r-best/packmate/sprites/battery.jpg

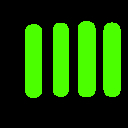
sprites/battery.jpg
