r-best/packmate/sprites/ui_base.jpg

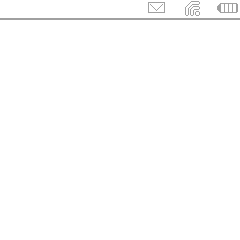
sprites/ui_base.jpg
