r-best/packmate/pcb/packmate.csv

Reference | Qty | Value | DNP | Exclude from BOM | Exclude from Board | Footprint | Datasheet
A1 | 1 | RaspberryPi_Pico_W |  |  |  | Module:RaspberryPi_Pico_Common_THT | https://datasheets.raspberrypi.com/picow/pico-w-datasheet.pdf
BT1 | 1 | Battery |  |  | Excluded from board
BZ1 | 1 | Buzzer |  |  |  | Buzzer_Beeper:Buzzer_12x9.5RM7.6
C1,C2,C4,C5,C6,C7,C8 | 7 | 0.1uf |  |  |  | Capacitor_SMD:C_01005_0402Metric
C3 | 1 | 400uf |  |  |  | Capacitor_SMD:CP_Elec_3x5.3
D1 | 1 | BLU |  |  |  | LED_SMD:LED_0201_0603Metric
D2 | 1 | RED |  |  |  | LED_SMD:LED_0201_0603Metric
D3 | 1 | GRN |  |  |  | LED_SMD:LED_0201_0603Metric
D4 | 1 | WHT |  |  |  | LED_SMD:LED_0201_0603Metric
D5 | 1 | Wireless In Use LED |  |  |  | LED_SMD:LED_0201_0603Metric
D6,D7,D8,D9,D10,D11,D12,D13,D14,D15 | 10 | WS2812B |  |  |  | LED_SMD:LED_WS2812B_PLCC4_5.0x5.0mm_P3.2mm | https://cdn-shop.adafruit.com/datasheets/WS2812B.pdf
J2 | 1 | DISPLAY |  |  |  | Connector_FFC-FPC:Hirose_FH12-12S-0.5SH_1x12-1MP_P0.50mm_Horizontal
J5 | 1 | Conn_01x04 |  |  | Excluded from board | Connector_PinHeader_2.54mm:PinHeader_1x04_P2.54mm_Vertical
J6 | 1 | Conn_01x02 |  |  | Excluded from board | Connector_JST:JST_PH_S2B-PH-K_1x02_P2.00mm_Horizontal
J7 | 1 | MICROSD |  |  |  | MSD-4-A.pretty:CONN9_MSD-4-A_SSD | MSD-4-A
Q1 | 1 | 2N7002E |  |  |  | Package_TO_SOT_SMD:SOT-23 | http://www.diodes.com/assets/Datasheets/ds30376.pdf
R1,R2,R3,R4 | 4 | 180 |  |  |  | Resistor_SMD:R_0201_0603Metric
R5,R6,R7,R8 | 4 | 10k |  |  |  | Resistor_SMD:R_0201_0603Metric
R9 | 1 | 10 |  |  |  | Resistor_SMD:R_0201_0603Metric
R10 | 1 | 20 |  |  |  | Resistor_SMD:R_0201_0603Metric
R11,R12 | 2 | 30k |  |  |  | Resistor_SMD:R_0201_0603Metric
SW1 | 1 | BTN |  |  |  | TL3315NF100Q:TL3315NF100Q_EWI
SW2 | 1 | Reset Button |  |  |  | Button_Switch_THT:SW_PUSH_6mm
SW3 | 1 | Left Button |  |  |  | Button_Switch_THT:SW_PUSH_6mm
SW4 | 1 | Right Button |  |  |  | Button_Switch_THT:SW_PUSH_6mm
SW6 | 1 | Wireless On/Off Switch |  |  |  | Button_Switch_THT:SW_E-Switch_EG1224_SPDT_Angled
U1 | 1 | UP |  |  |  | TMAG5231C1GQDBZR.pretty:SOT-23-3_DBZ_TEX | https://www.ti.com/lit/gpn/tmag5231
U2 | 1 | DWN |  |  |  | TMAG5231C1GQDBZR.pretty:SOT-23-3_DBZ_TEX | https://www.ti.com/lit/gpn/tmag5231
U3 | 1 | LFT |  |  |  | TMAG5231C1GQDBZR.pretty:SOT-23-3_DBZ_TEX | https://www.ti.com/lit/gpn/tmag5231
U4 | 1 | RHT |  |  |  | TMAG5231C1GQDBZR.pretty:SOT-23-3_DBZ_TEX | https://www.ti.com/lit/gpn/tmag5231
