r-best/packmate/(list of files, cad)

Other CAD files:
pcb/Untitled.blend
