r-best/packmate/pcb/packmate.kicad_pcb

## KiCad design pcb/packmate.kicad_pcb (2026-10-18)

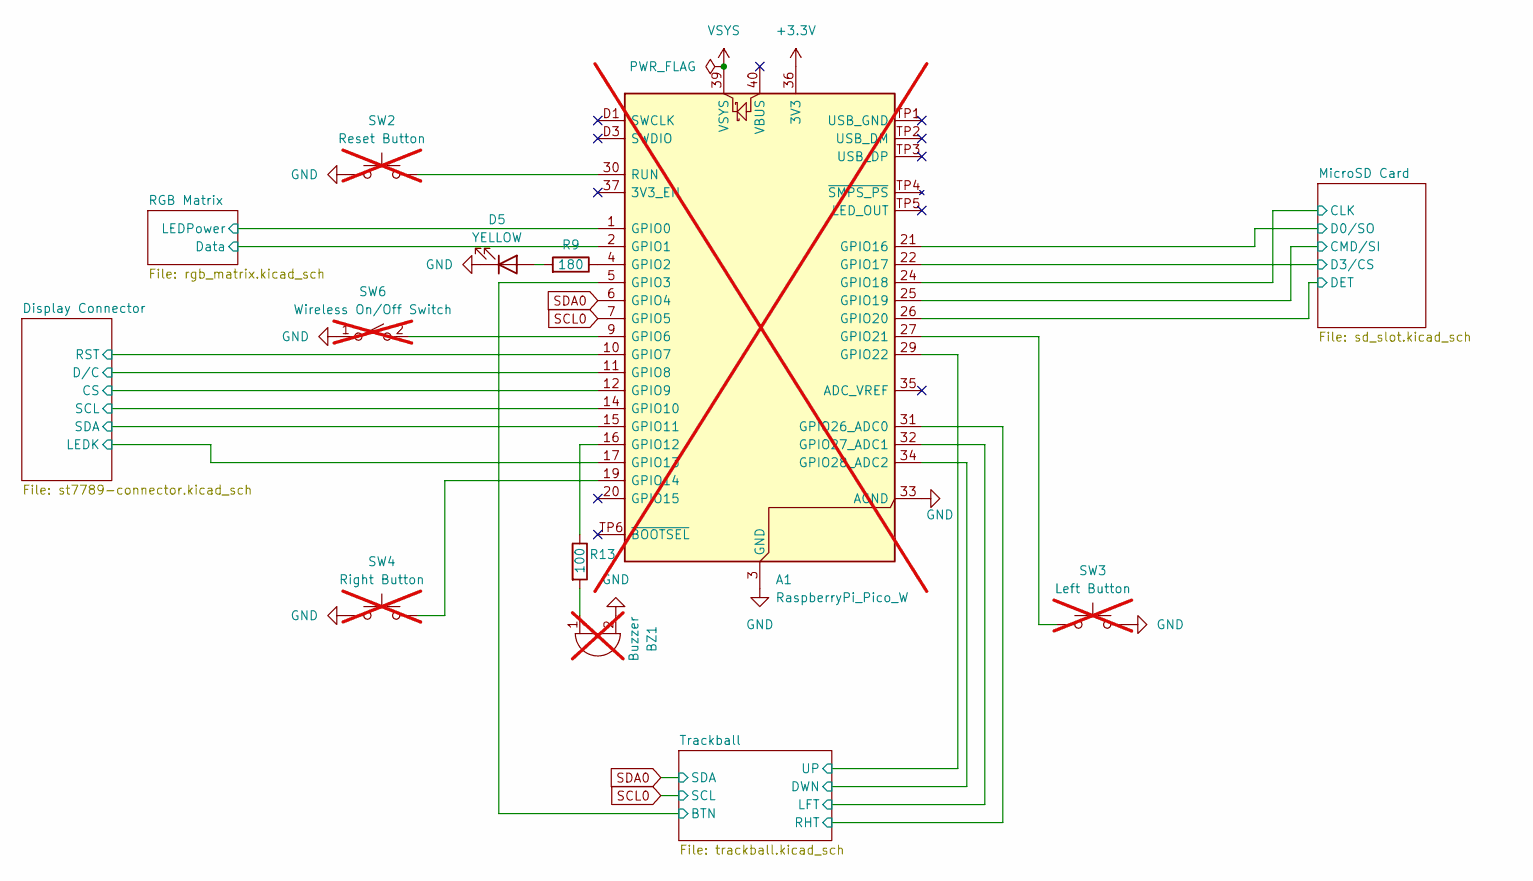
[picture p3: schematic packmate.kicad_sch]

Parts:
A1: RaspberryPi_Pico_W; RaspberryPi_Pico_Common_THT; not fitted
BZ1: Buzzer; Buzzer_TDK_PS1240P02BT_D12.2mm_H6.5mm; MPN PS1240P02BT; not fitted
D5: YELLOW; LED_0402_1005Metric; MPN APHHS1005SYCK
R9: 180; R_0603_1608Metric; MPN CRGCQ0603F180R
R13: 100; R_0603_1608Metric; MPN ERJ-3EKF1000V
SW2: Reset Button; SW_PUSH_6mm; MPN B3F-1000; not fitted
SW3: Left Button; SW_PUSH_6mm; MPN B3F-1000; not fitted
SW4: Right Button; SW_PUSH_6mm; MPN B3F-1000; not fitted
SW6: Wireless On/Off Switch; SW_E-Switch_EG1224_SPDT_Angled; MPN EG1224; not fitted

Connections:
+3.3V: A1.36 (3V3); also elsewhere on the board
/Display Connector/CS: A1.12 (GPIO9); also elsewhere on the board
/Display Connector/D/C: A1.11 (GPIO8); also elsewhere on the board
/Display Connector/LEDK: A1.17 (GPIO13); also elsewhere on the board
/Display Connector/RST: A1.10 (GPIO7); also elsewhere on the board
/Display Connector/SCL: A1.14 (GPIO10); also elsewhere on the board
/Display Connector/SDA: A1.15 (GPIO11); also elsewhere on the board
/MicroSD Card/CLK: A1.24 (GPIO18); also elsewhere on the board
/MicroSD Card/CMD/SI: A1.25 (GPIO19); also elsewhere on the board
/MicroSD Card/D0/SO: A1.21 (GPIO16); also elsewhere on the board
/MicroSD Card/D3/CS: A1.22 (GPIO17); also elsewhere on the board
/MicroSD Card/DET: A1.26 (GPIO20); also elsewhere on the board
/RGB Matrix/Data: A1.2 (GPIO1); also elsewhere on the board
/RGB Matrix/LEDPower: A1.1 (GPIO0); also elsewhere on the board
/Trackball/BTN: A1.5 (GPIO3); also elsewhere on the board
/Trackball/DWN: A1.34 (GPIO28_ADC2); also elsewhere on the board
/Trackball/LFT: A1.32 (GPIO27_ADC1); also elsewhere on the board
/Trackball/RHT: A1.31 (GPIO26_ADC0); also elsewhere on the board
/Trackball/UP: A1.29 (GPIO22); also elsewhere on the board
GND: A1.3 (GND), A1.8 (GND), A1.13 (GND), A1.18 (GND), A1.23 (GND), A1.28 (GND), A1.33 (AGND), A1.38 (GND), A1.D2 (GND), BZ1.2 (-), D5.1 (K), SW2.1, SW3.1, SW4.1, SW6.1 (A); also elsewhere on the board
unnamed: A1.4 (GPIO2), R9.1
unnamed: A1.9 (GPIO6), SW6.2 (B)
unnamed: A1.16 (GPIO12), R13.1
unnamed: A1.19 (GPIO14), SW4.2
unnamed: A1.27 (GPIO21), SW3.2
unnamed: A1.30 (RUN), SW2.2
unnamed: BZ1.1 (+), R13.2
unnamed: D5.2 (A), R9.2
SCL0: A1.7 (GPIO5); also elsewhere on the board
SDA0: A1.6 (GPIO4); also elsewhere on the board
VSYS: A1.39 (VSYS); also elsewhere on the board

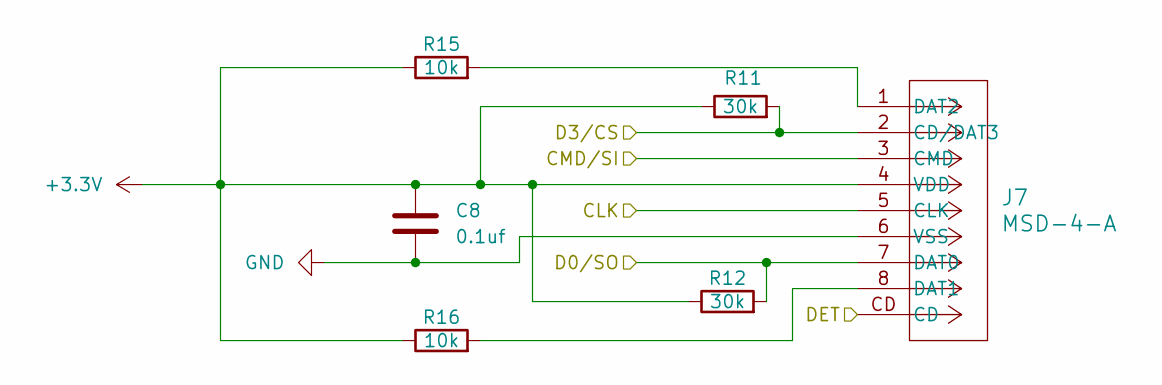
[picture p4: schematic sd_slot.kicad_sch]

Parts:
C8: 0.1uf; C_0402_1005Metric; MPN GRM155R71H104KE14D
J7: MSD-4-A; CONN9_MSD-4-A_SSD; MPN MSD-4-A
R11, R12: 30k; R_0603_1608Metric; MPN RC0603FR-0730KL
R15, R16: 10k; R_0603_1608Metric; MPN CRCW060310K0FKEA

Connections:
+3.3V: C8.2, J7.4 (VDD), R11.1, R12.1, R15.1, R16.1; also elsewhere on the board
/MicroSD Card/CLK: J7.5 (CLK); also elsewhere on the board
/MicroSD Card/CMD/SI: J7.3 (CMD); also elsewhere on the board
/MicroSD Card/D0/SO: J7.7 (DAT0), R12.2; also elsewhere on the board
/MicroSD Card/D3/CS: J7.2 (CD/DAT3), R11.2; also elsewhere on the board
/MicroSD Card/DET: J7.CD; also elsewhere on the board
GND: C8.1, J7.6 (VSS); also elsewhere on the board
unnamed: J7.8 (DAT1), R16.2
unnamed: J7.1 (DAT2), R15.2

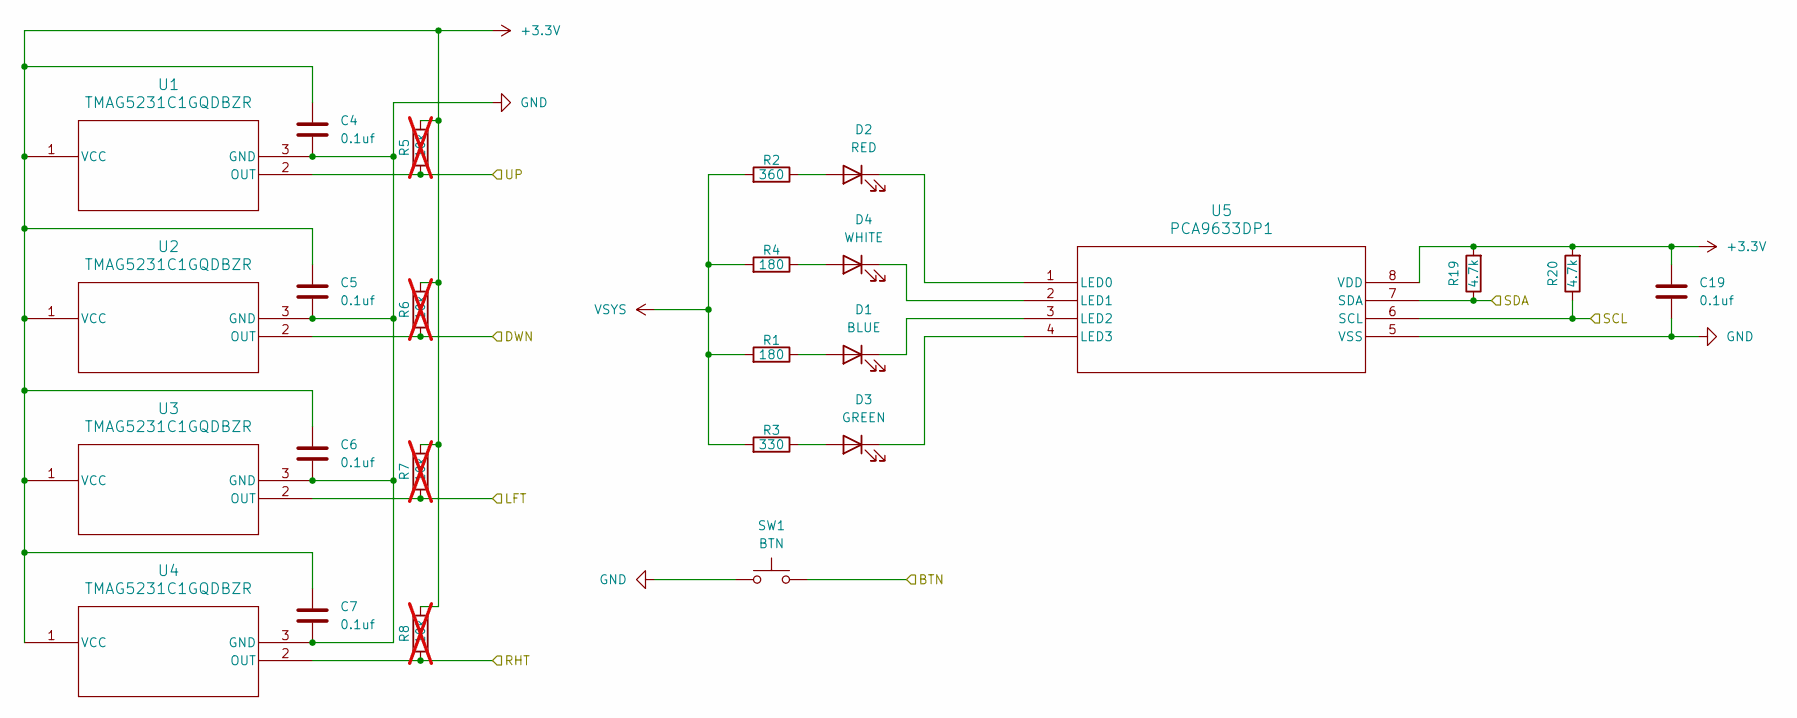
[picture p5: schematic trackball.kicad_sch]

Parts:
C4, C5, C6, C7, C19: 0.1uf; C_0402_1005Metric; MPN GRM155R71H104KE14D
D1: BLUE; LED_0402_1005Metric; MPN APHHS1005QBC/D
D2: RED; LED_0402_1005Metric; MPN APHHS1005SURCK
D3: GREEN; LED_0402_1005Metric; MPN APHHS1005ZGC
D4: WHITE; LED_0402_1005Metric; MPN IN-S42BT5UW
R1, R4: 180; R_0201_0603Metric; MPN RC0201FR-07180RL
R2: 360; R_0201_0603Metric; MPN RC0201FR-07360RL
R3: 330; R_0201_0603Metric; MPN RC0201FR-07330RL
R5, R6, R7, R8: 10k; R_0201_0603Metric; MPN RC0201FR-0710KL; not fitted
R19, R20: 4.7k; R_0603_1608Metric; MPN RC0603FR-074K7L
SW1: BTN; TL3315NF100Q_EWI; MPN TL3315NF100Q
U1, U2, U3, U4: TMAG5231C1GQDBZR; SOT-23-3_DBZ_TEX; MPN TMAG5231C1GQDBZR
U5: PCA9633DP1; TSSOP-8_3x3mm_P0.65mm; MPN PCA9633DP1,118

Connections:
+3.3V: C4.1, C5.1, C6.1, C7.1, C19.2, R5.2, R6.2, R7.2, R8.2, R19.2, R20.2, U1.1 (VCC), U2.1 (VCC), U3.1 (VCC), U4.1 (VCC), U5.8 (VDD); also elsewhere on the board
/Trackball/BTN: SW1.2; also elsewhere on the board
/Trackball/DWN: R6.1, U2.2 (OUT); also elsewhere on the board
/Trackball/LFT: R7.1, U3.2 (OUT); also elsewhere on the board
/Trackball/RHT: R8.1, U4.2 (OUT); also elsewhere on the board
/Trackball/UP: R5.1, U1.2 (OUT); also elsewhere on the board
GND: C4.2, C5.2, C6.2, C7.2, C19.1, SW1.1, U1.3 (GND), U2.3 (GND), U3.3 (GND), U4.3 (GND), U5.5 (VSS); also elsewhere on the board
unnamed: D1.2 (A), R1.1
unnamed: D1.1 (K), U5.3 (LED2)
unnamed: D2.2 (A), R2.1
unnamed: D2.1 (K), U5.1 (LED0)
unnamed: D3.2 (A), R3.1
unnamed: D3.1 (K), U5.4 (LED3)
unnamed: D4.2 (A), R4.1
unnamed: D4.1 (K), U5.2 (LED1)
SCL0: R20.1, U5.6 (SCL); also elsewhere on the board
SDA0: R19.1, U5.7 (SDA); also elsewhere on the board
VSYS: R1.2, R2.2, R3.2, R4.2; also elsewhere on the board

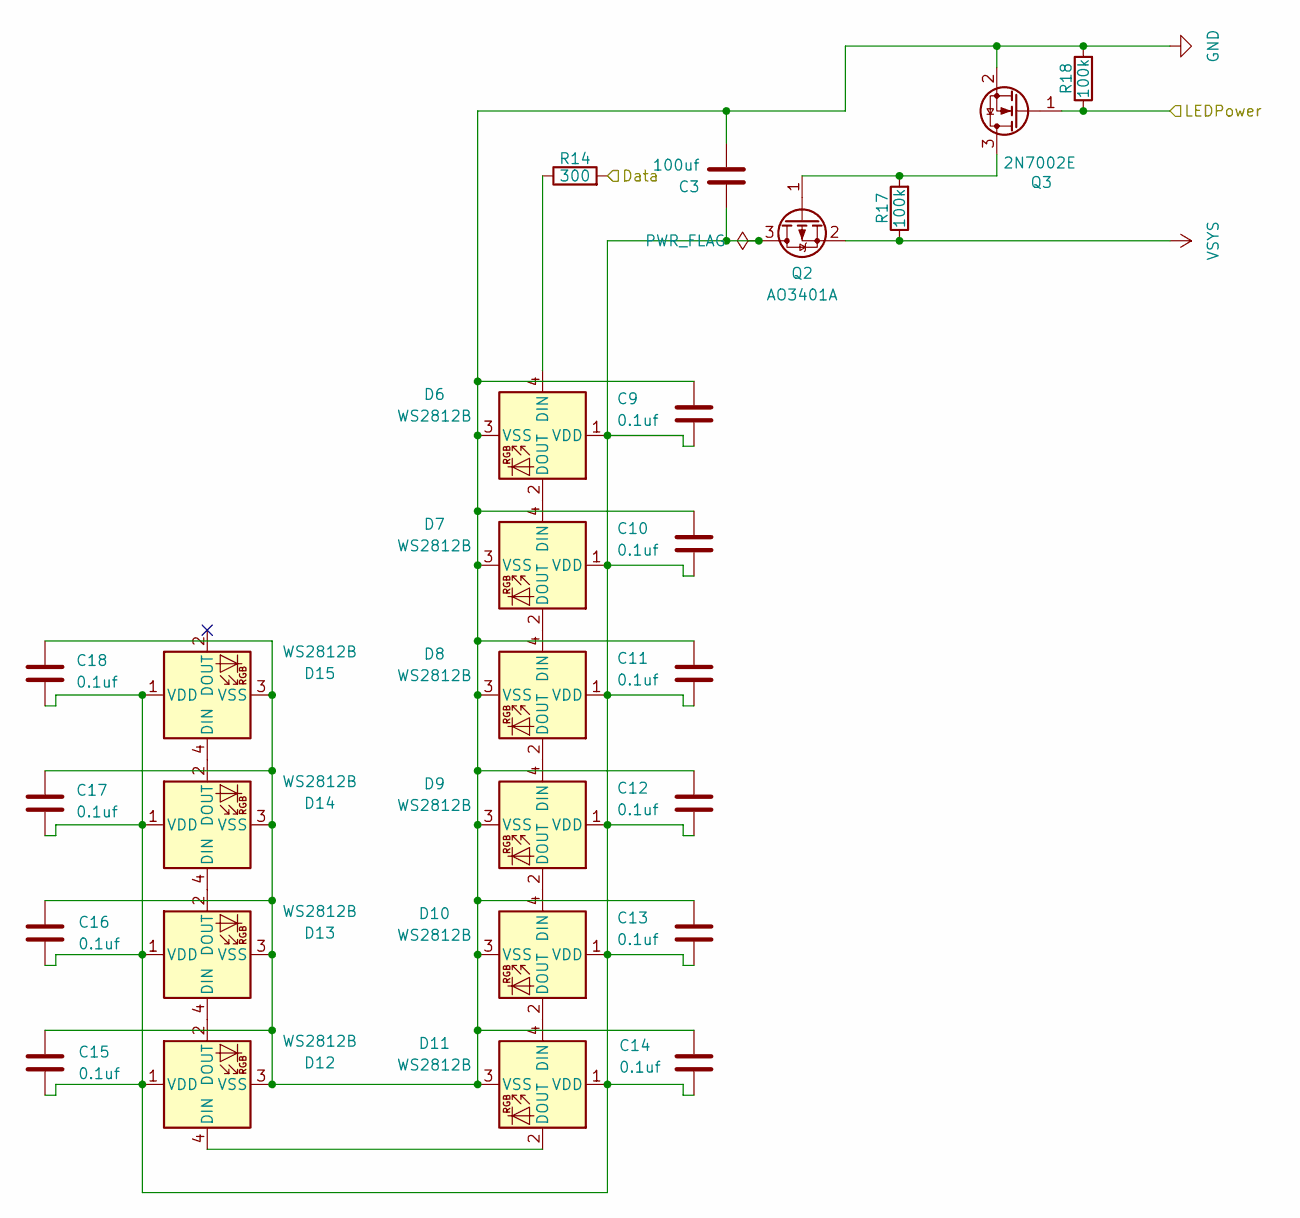
[picture p6: schematic rgb_matrix.kicad_sch]

Parts:
C3: 100uf; C_1206_3216Metric; MPN GRM31CR61A107MEA8L
C9, C10, C11, C12, C13, C14, C15, C16, C17, C18: 0.1uf; C_0402_1005Metric; MPN GRM155R71H104KE14D
D6, D7, D8, D9, D10, D11, D12, D13, D14, D15: WS2812B; LED_WS2812B_PLCC4_5.0x5.0mm_P3.2mm; MPN WS2812B
Q2: AO3401A; SOT-23; MPN AO3401A
Q3: 2N7002E; SOT-23; MPN 2N7002E-7-F
R14: 300; R_0603_1608Metric; MPN ERJ-3GEYJ301V
R17, R18: 100k; R_0603_1608Metric; MPN CRCW0603100KFKEA

Connections:
/RGB Matrix/Data: R14.2; also elsewhere on the board
/RGB Matrix/LEDPower: Q3.1 (G), R18.1; also elsewhere on the board
GND: C3.2, C9.1, C10.1, C11.1, C12.1, C13.1, C14.1, C15.1, C16.1, C17.1, C18.1, D6.3 (VSS), D7.3 (VSS), D8.3 (VSS), D9.3 (VSS), D10.3 (VSS), D11.3 (VSS), D12.3 (VSS), D13.3 (VSS), D14.3 (VSS), D15.3 (VSS), Q3.2 (S), R18.2; also elsewhere on the board
unnamed: D6.4 (DIN), R14.1
unnamed: D6.2 (DOUT), D7.4 (DIN)
unnamed: D7.2 (DOUT), D8.4 (DIN)
unnamed: D8.2 (DOUT), D9.4 (DIN)
unnamed: D9.2 (DOUT), D10.4 (DIN)
unnamed: D10.2 (DOUT), D11.4 (DIN)
unnamed: C3.1, C9.2, C10.2, C11.2, C12.2, C13.2, C14.2, C15.2, C16.2, C17.2, C18.2, D6.1 (VDD), D7.1 (VDD), D8.1 (VDD), D9.1 (VDD), D10.1 (VDD), D11.1 (VDD), D12.1 (VDD), D13.1 (VDD), D14.1 (VDD), D15.1 (VDD), Q2.3 (D)
unnamed: D11.2 (DOUT), D12.4 (DIN)
unnamed: D12.2 (DOUT), D13.4 (DIN)
unnamed: D13.2 (DOUT), D14.4 (DIN)
unnamed: D14.2 (DOUT), D15.4 (DIN)
unnamed: Q2.1 (G), Q3.3 (D), R17.2
VSYS: Q2.2 (S), R17.1; also elsewhere on the board

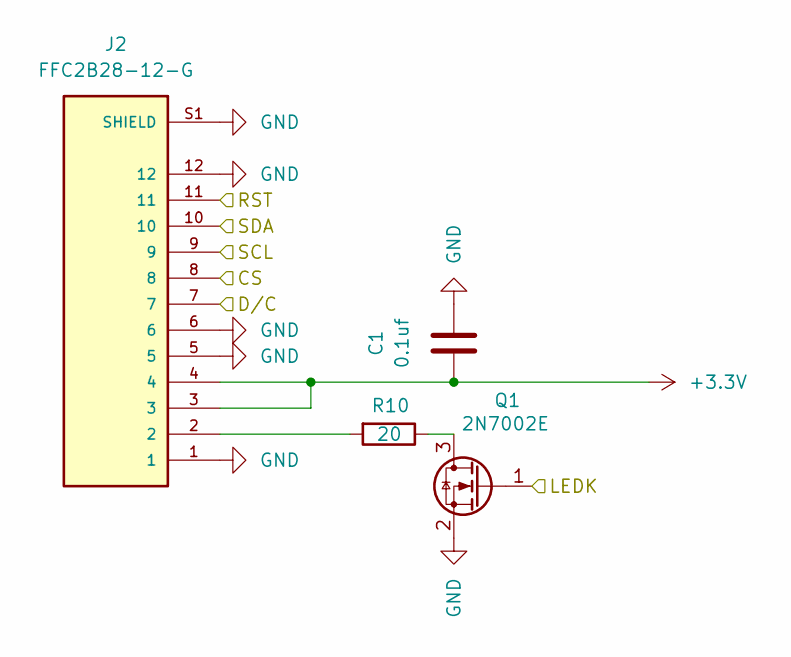
[picture p7: schematic st7789-connector.kicad_sch]

Parts:
C1: 0.1uf; C_0402_1005Metric; MPN GRM155R71H104KE14D
J2: FFC2B28-12-G; GCT_FFC2B28-12-G; MPN FFC2B28-12-G; DigiKey_Part_Number 2073-FFC2B28-12-GCT-ND
Q1: 2N7002E; SOT-23; MPN 2N7002E-7-F
R10: 20; R_0603_1608Metric; MPN RMCF0603JT20R0

Connections:
+3.3V: C1.2, J2.3, J2.4; also elsewhere on the board
/Display Connector/CS: J2.8; also elsewhere on the board
/Display Connector/D/C: J2.7; also elsewhere on the board
/Display Connector/LEDK: Q1.1 (G); also elsewhere on the board
/Display Connector/RST: J2.11; also elsewhere on the board
/Display Connector/SCL: J2.9; also elsewhere on the board
/Display Connector/SDA: J2.10; also elsewhere on the board
GND: C1.1, J2.1, J2.5, J2.6, J2.12, J2.S1 (SHIELD), J2.S2 (SHIELD), Q1.2 (S); also elsewhere on the board
unnamed: J2.2, R10.2
unnamed: Q1.3 (D), R10.1

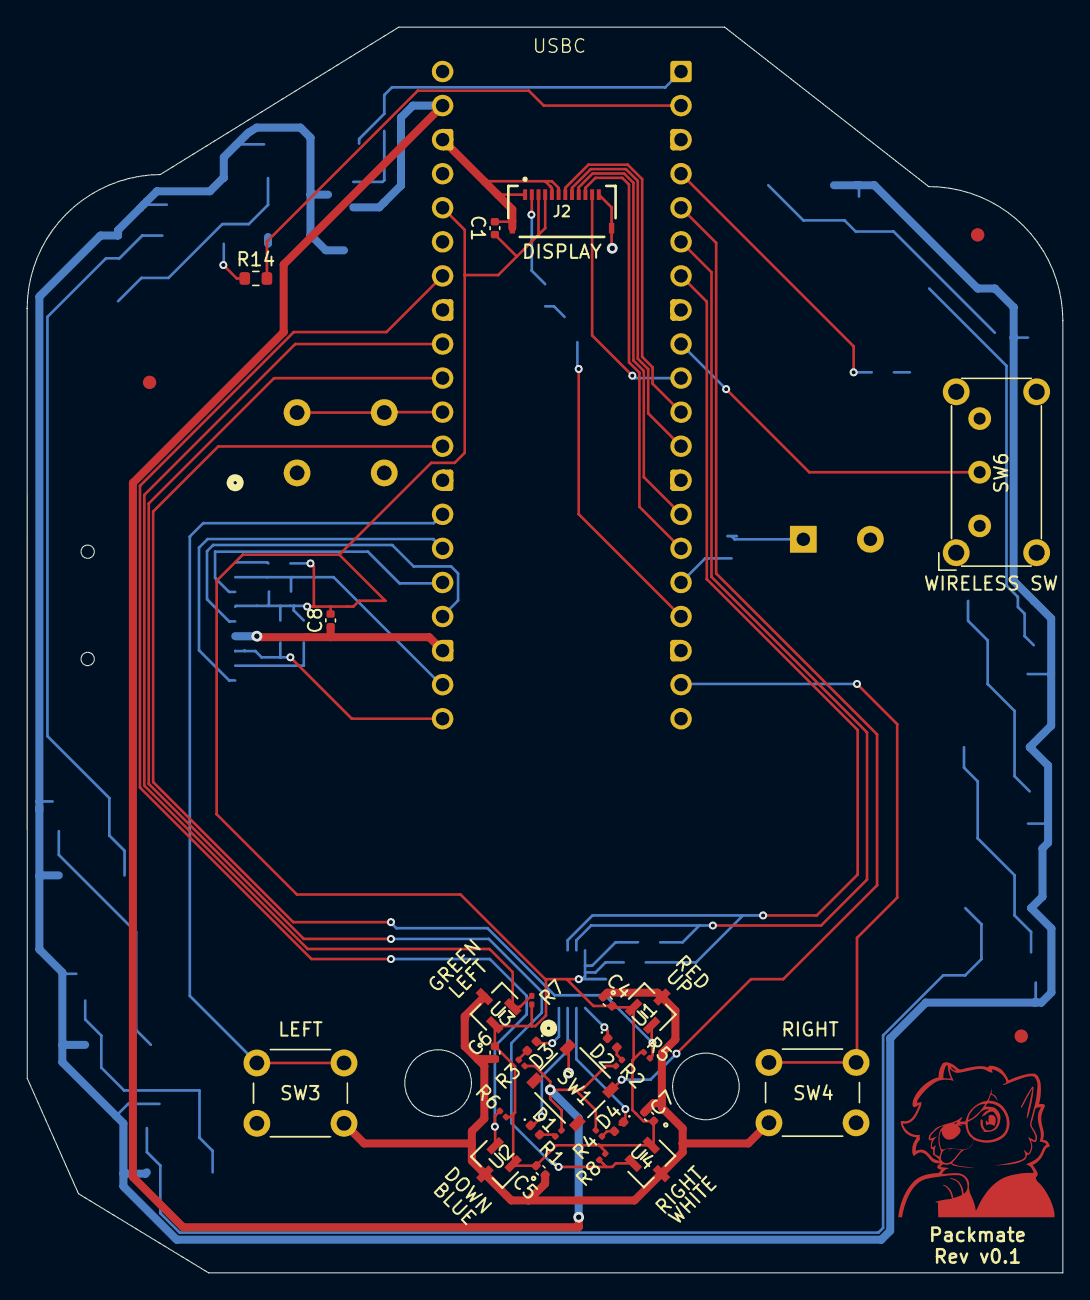
[picture p8: board packmate.kicad_pcb from above]

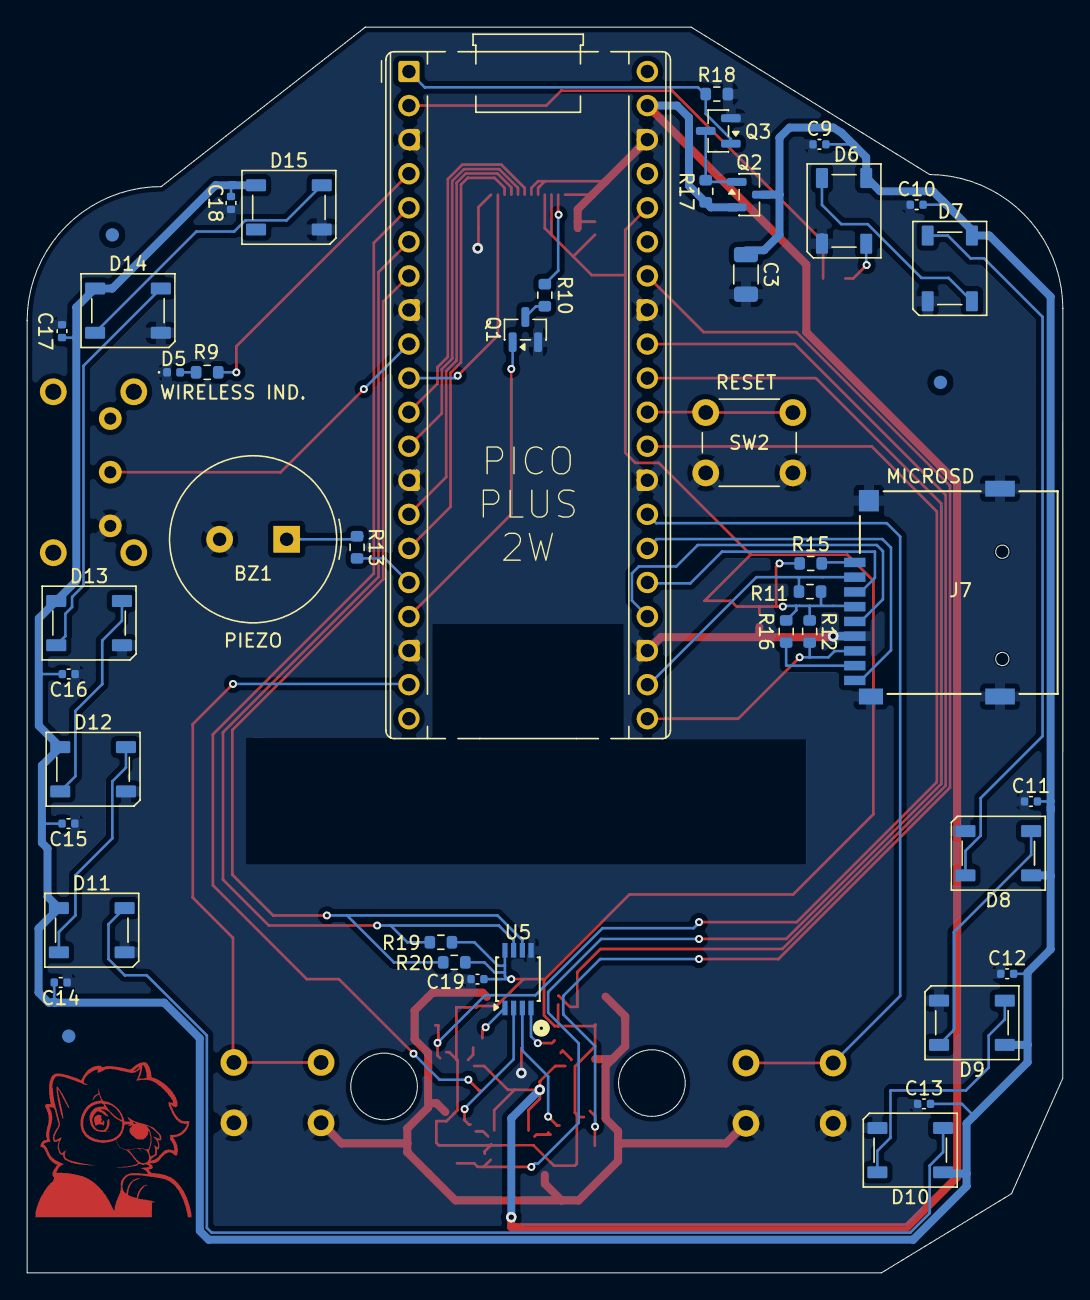
[picture p9: board packmate.kicad_pcb from below]

Board: 2 copper layers, 77.2 x 92.9 mm, 76 parts (45 on the bottom side), 55 nets.

Other parts of the board:
FID1, FID2, FID3, FID4, FID5, FID6: Fiducial_1mm_Mask2mm
