r-best/packmate/main.cpp

#include <stdio.h>
#include "pico/stdlib.h"
#include "pico/multicore.h"
#include "hardware/spi.h"
#include "pico/cyw43_arch.h"
#include "hardware/gpio.h"
#include "hardware/structs/xip.h"

#include "src/hardware/watchdog.h"
#include "src/screens/screen_manager.h"
#include "src/screens/home/home.h"
#include "src/screens/error/error.h"
#include "src/screens/boot/boot.h"
#include "src/screens/debug/debug.h"
#include "src/hardware/trackball.h"
#include "src/hardware/rgb_matrix.h"
#include "src/hardware/lcd.h"
#include "src/hardware/sd.h"
#include "src/hardware/buzzer.h"

#define DEBUG

#ifdef DEBUG
#include "tusb.h"
#endif

uint8_t MAIN_FPS = 60;
uint32_t FRAME_INTERVAL_US = 1000000 / MAIN_FPS; // Storing this as microseconds because the timer function returns microseconds
uint32_t WAIT_INTERVAL_MS = FRAME_INTERVAL_US / 4 / 1000; // Wait 1/4 of frame interval between loops to save CPU, no need to check constantly. Could probably even drop to 1/2

void set_fps(uint8_t fps) {
    MAIN_FPS = fps;
    FRAME_INTERVAL_US = 1000000 / MAIN_FPS;
}

BootScreen *bootScreen;

int init_debug_connections() {
    stdio_init_all();

    // Wait for terminal connection (with 5s timeout)
    for (int i = 0; i < 500; i++) {
        if (tud_cdc_connected()) break;
        sleep_ms(10);
    }
    sleep_ms(200);
    return 0;
}

int init_psram() {
    // Configure GPIO 47 as QSPI CS1 for the PSRAM chip
    gpio_set_function(PIMORONI_PICO_PLUS2_W_PSRAM_CS_PIN, GPIO_FUNC_XIP_CS1);

    // XIP window 1 is read-only by default; must opt in to writes for PSRAM.
    // Covers both cached (0x11000000) and uncached (0x15000000)
    // https://forums.raspberrypi.com/viewtopic.php?t=390346
    hw_set_bits(&xip_ctrl_hw->ctrl, XIP_CTRL_WRITABLE_M1_BITS);

    return 0;
}

int init_secondary_hardware() {
    int status;

    sleep_ms(500);

    printf("Initializing PSRAM\n");
    status = init_psram();
    bootScreen->update_status(3, status==0);

    printf("Mounting SD card\n");
    status = SD::init();
    bootScreen->update_status(4, status==0);

    sleep_ms(500);

    printf("Initializing buzzer\n");
    status = Buzzer::init();
    bootScreen->update_status(5, status==0);

    sleep_ms(500);

    // Initialise the Wi-Fi chip
    printf("Initializing wifi chip\n");
    if (cyw43_arch_init()) {
        printf("Wi-Fi init failed\n");
        bootScreen->update_status(6, false);
        return -1;
    }
    bootScreen->update_status(6, true);

    sleep_ms(500);

    Buzzer::play_melody("boot");
    return 0;
}

void core1_main() {
    printf("Second core initialized\n");

    init_secondary_hardware();
}

int main() {
    #ifdef DEBUG
    init_debug_connections();
    #endif

    printf("------------------------------------\n");
    printf("Starting Packmate!\n");

    bootScreen = new BootScreen();

    printf("Initializing screen\n");
    int status = LCD::init();
    bootScreen->update_status(0, status==0);
    
    // Try to initialize trackball first so we have the LED to light red on error
    printf("Initializing trackball\n");
    status = Trackball::init();
    bootScreen->update_status(1, status==0);

    multicore_launch_core1(core1_main);

    // Initialize RGB matrix
    printf("Initializing RGB matrix\n");
    status = RGBMatrix::init();
    bootScreen->update_status(2, status==0);

    InputState input;

    screenManager.push(new HomeScreen());

    // if (true) {
    if (watchdog::is_watchdog_reboot()) {
        printf("Rebooted by watchdog - there was some kind of error\n");
        screenManager.push(new ErrorScreen("Watchdog reboot"));
    }

    screenManager.push(bootScreen);

    watchdog::start();

    // Main loop
    uint32_t lastUpdateTime = time_us_32();
    while(true){
        watchdog::feed();
        if (screenManager.active()->id() != ScreenID::SCREEN_ERROR && screenManager.active()->id() != ScreenID::SCREEN_BOOT)
            watchdog::set_active_screen(screenManager.active());

        uint32_t now = time_us_32();
        if (now - lastUpdateTime >= FRAME_INTERVAL_US) {
            lastUpdateTime = now;

            // Update inputs
            Trackball::get_state(&input.trackball);

            // Long-press trackball opens debug screen from anywhere
            if (input.trackball.long_pressed) {
                if (screenManager.active()->id() != ScreenID::SCREEN_DEBUG) {
                    screenManager.push(new DebugScreen());
                }
            }

            // Update current screen
            bool updated = screenManager.update(&input);
            if (updated) {
                LCD::update_screen();
            }
        }
        sleep_ms(WAIT_INTERVAL_MS);
    }
}
