r-best/packmate/(commit log)

2026-04-11 We're cooking chat (added mutlicore, sprite loading w/ reserved memory slots, buzzer)
    [buzzer.cpp, main.cpp, screen.cpp, screen.h, sd.cpp, sd.h]
2026-04-12 Adding kicad empty project, will need to learn how this works later
    [packmate.kicad_pcb, packmate.kicad_sch]
2026-04-15 Moving buzzer impl to hardware
    [buzzer.cpp, main.cpp]
2026-04-24 Fixing rgb matrix init issue (keep all i2c on core 0)
    [main.cpp, rgb_matrix.cpp, rgb_matrix.h]
2026-04-24 Fix rgb startup flash
    [rgb_matrix.cpp]
2026-04-24 Fixing some flicker issues and completing boot screen logic
    [lcd.cpp, main.cpp, screen.h]
2026-05-03 Implementing watchdog for crash handling
    [main.cpp, screen.h, trackball.cpp]
2026-05-03 Moving watchdog impl to namespace, to be expanded with crash data
    [main.cpp, watchdog.cpp, watchdog.h]
2026-05-03 Adding watchdog info to error screen
    [main.cpp, screen.cpp, screen.h]
2026-05-16 Adding frame support to draw_sprite
2026-10-04 I think the pcb is pretty much done. Needs small things like test pads but it should at least work at this stage
2026-10-11 Still tidying pcb design
2026-10-12 Still improving pcb, I learned what a fiducial is today
2026-10-12 Removing unused files from pcb
2026-10-12 Removing unused ki-lime-pi-pico library
2026-10-16 I think the PCB is almost done for real this time chat. Just gotta add part numbers for the BOM
2026-10-16 Fixing microsd card slot 3d model
2026-10-18 I think the PCB is ready to ship, just gonna tidy up a couple more things
2026-10-19 PCB has been submitted to pcbway!
2026-10-19 Exported glb 3d model of pcb
